bwhelm/aristotle-split33-2021/locations.md

# Locations of Parts

| Component |  $X$ pos |  $Y$ pos | Rot |
|:---|---:|---:|---:|
| D2A1 |  $79.63$ | $116.87$ |  $90$ |
| J1 |  $72.96$ | $123.01$ | $270$ |
| J3 |  $69.27$ | $114.91$ | $0$ |
| Mount Hole #1 2.2mm |  $61.18$ | $115.83$ | $0$ |
| Mount Hole #2 2.2mm |  $76.42$ | $115.83$ | $0$ |
| Mount Hole #3 2.2mm |  $79.69$ |  $80.34$ | $0$ |
| SW1 | $102.38$ | $142.15$ |  $24$ |
| SW2 |  $60.05$ | $137.42$ | $0$ |
| U1 |  $68.80$ |  $96.70$ | $270$ |
| Top of board | |  $78.62$ | |
| Left of board |  $58.51$ | | |
| Bottom of J3 | | $119.00$ | |
| Right of U1 |  $78.00$ | | |
| Right of Mount |  $81.41$ | | |

# Dimensions of MCU Cover:

$(119 - 78.62) \times (78 - 58.51)$
= $40.38 \times 19.49$ ... plus I need the extra loop for the third mounting hole

... Of course, I need to identify the locations of the mounting holes very carefully.... Here they are relative to the bottom left corner of the cover:

MH #1: $(61.18 - 58.51) \times (119 - 115.83) =  2.67 \times  3.17$

MH #2: $(76.42 - 58.51) \times (119 - 115.83) = 17.91 \times  3.17$

MH #3: $(79.69 - 58.51) \times (119 -  80.34) = 21.18 \times 38.66$

# Things to Check

What spacing between keys do I want? Should I make it all for choc keycaps, or should I allow the use of DSA keycaps? ... How much of a compromise will it be to allow the use of choc2 switches?
