bwhelm/aristotle-split33-2021/aristotle_split_2021_33_mcu_cover.stl

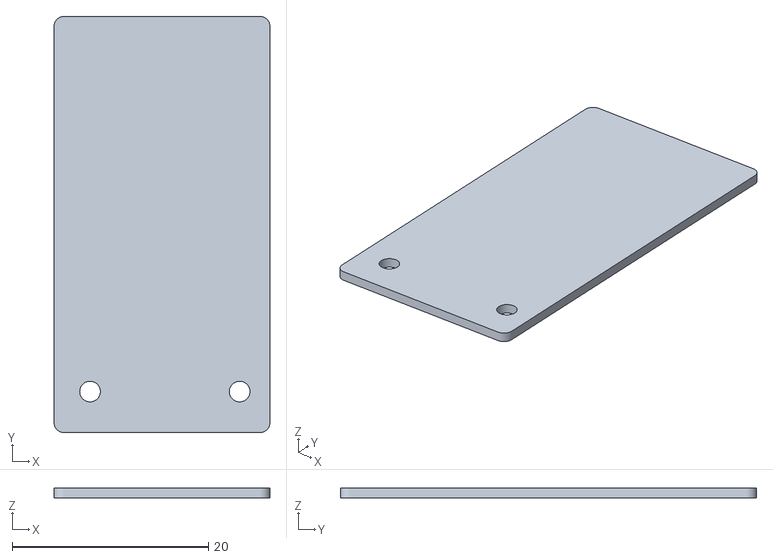
[picture p1: CAD file, 2021-08-19]
aristotle_split_2021_33_mcu_cover.stl
22.0 x 42.4 x 1.00
