bwhelm/aristotle-split33-2021/case/aristotle_split_33_keyboard-2021-case-right.stl

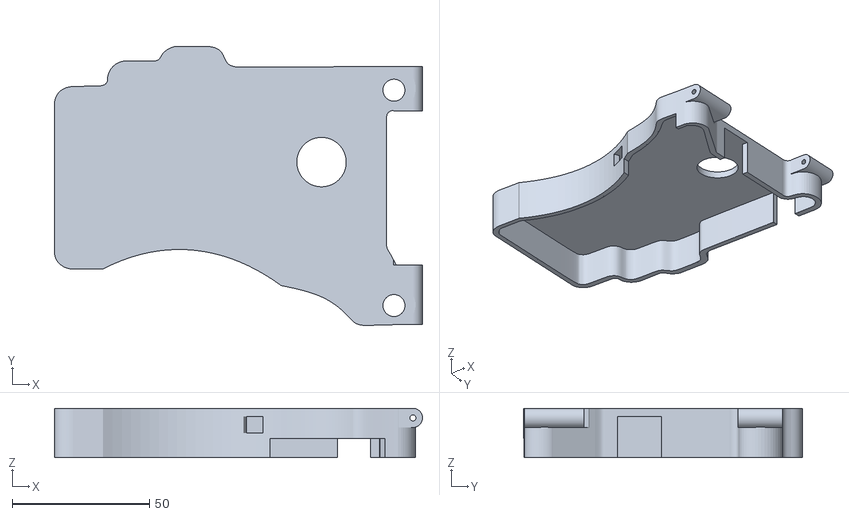
[picture p2: CAD file, 2021-08-19]
case/aristotle_split_33_keyboard-2021-case-right.stl
134.1 x 101.6 x 18.0
