bwhelm/aristotle-split33-2021/case/aristotle_split_33_keyboard-2021-case-open.stl

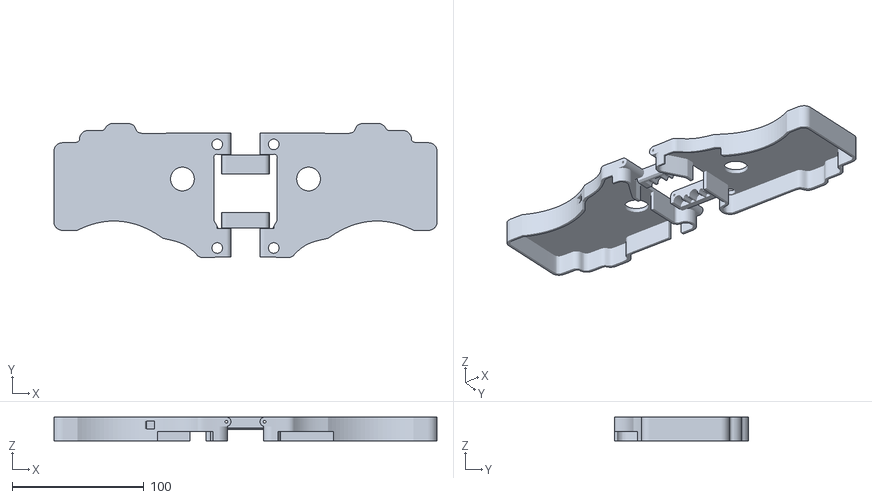
[picture p3: CAD file, 2021-08-19]
case/aristotle_split_33_keyboard-2021-case-open.stl
290.2 x 101.6 x 18.0
