bwhelm/aristotle-split33-2021/case/aristotle_split_33_keyboard-2021-case-hinge.stl

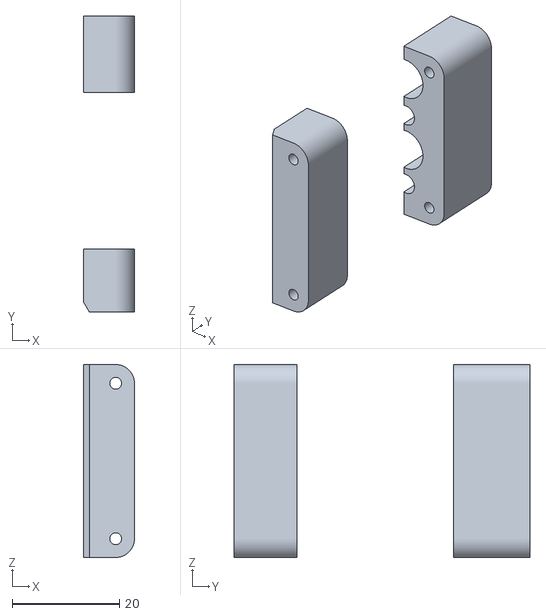
[picture p4: CAD file, 2021-08-19]
case/aristotle_split_33_keyboard-2021-case-hinge.stl
9.50 x 55.2 x 36.0
