bwhelm/aristotle-split33-2021/case/aristotle_split_33_keyboard-2021-case-closed.stl

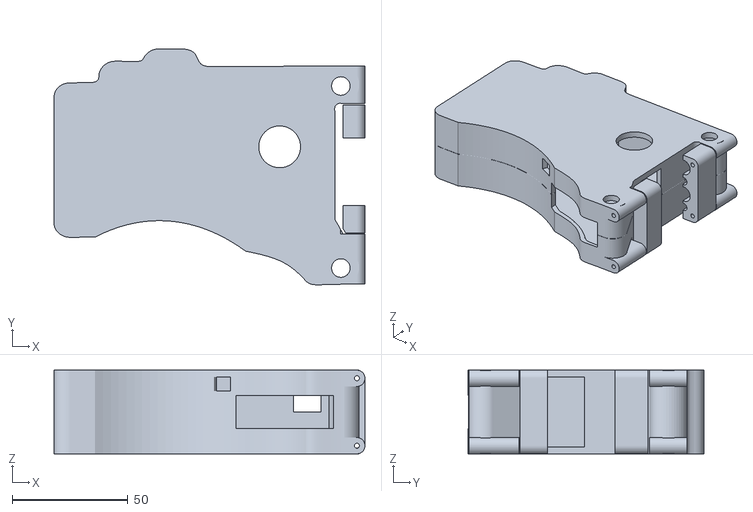
[picture p5: CAD file, 2021-08-19]
case/aristotle_split_33_keyboard-2021-case-closed.stl
134.1 x 101.6 x 36.1
