bwhelm/aristotle-split33-2021/case/aristotle_split_33_keyboard-2021-case-left.stl

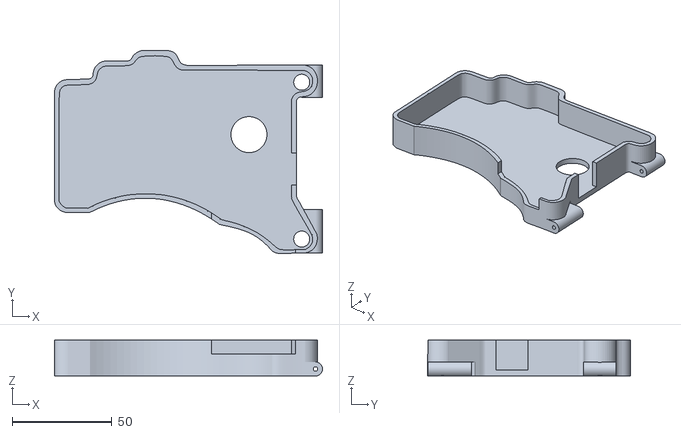
[picture p6: CAD file, 2021-08-19]
case/aristotle_split_33_keyboard-2021-case-left.stl
134.1 x 101.6 x 18.0
