bwhelm/aristotle-split33-2021/(list of files, cad)

Other CAD files:
aristotle_split_2021_33_mcu_cover.scad
aristotle_split_2021_33_mcu_cover.dxf
