bwhelm/aristotle-split33-2021/aristotle_split_33_keyboard-2021.kicad_pcb

## KiCad design aristotle_split_33_keyboard-2021.kicad_pcb (2021-08-19)

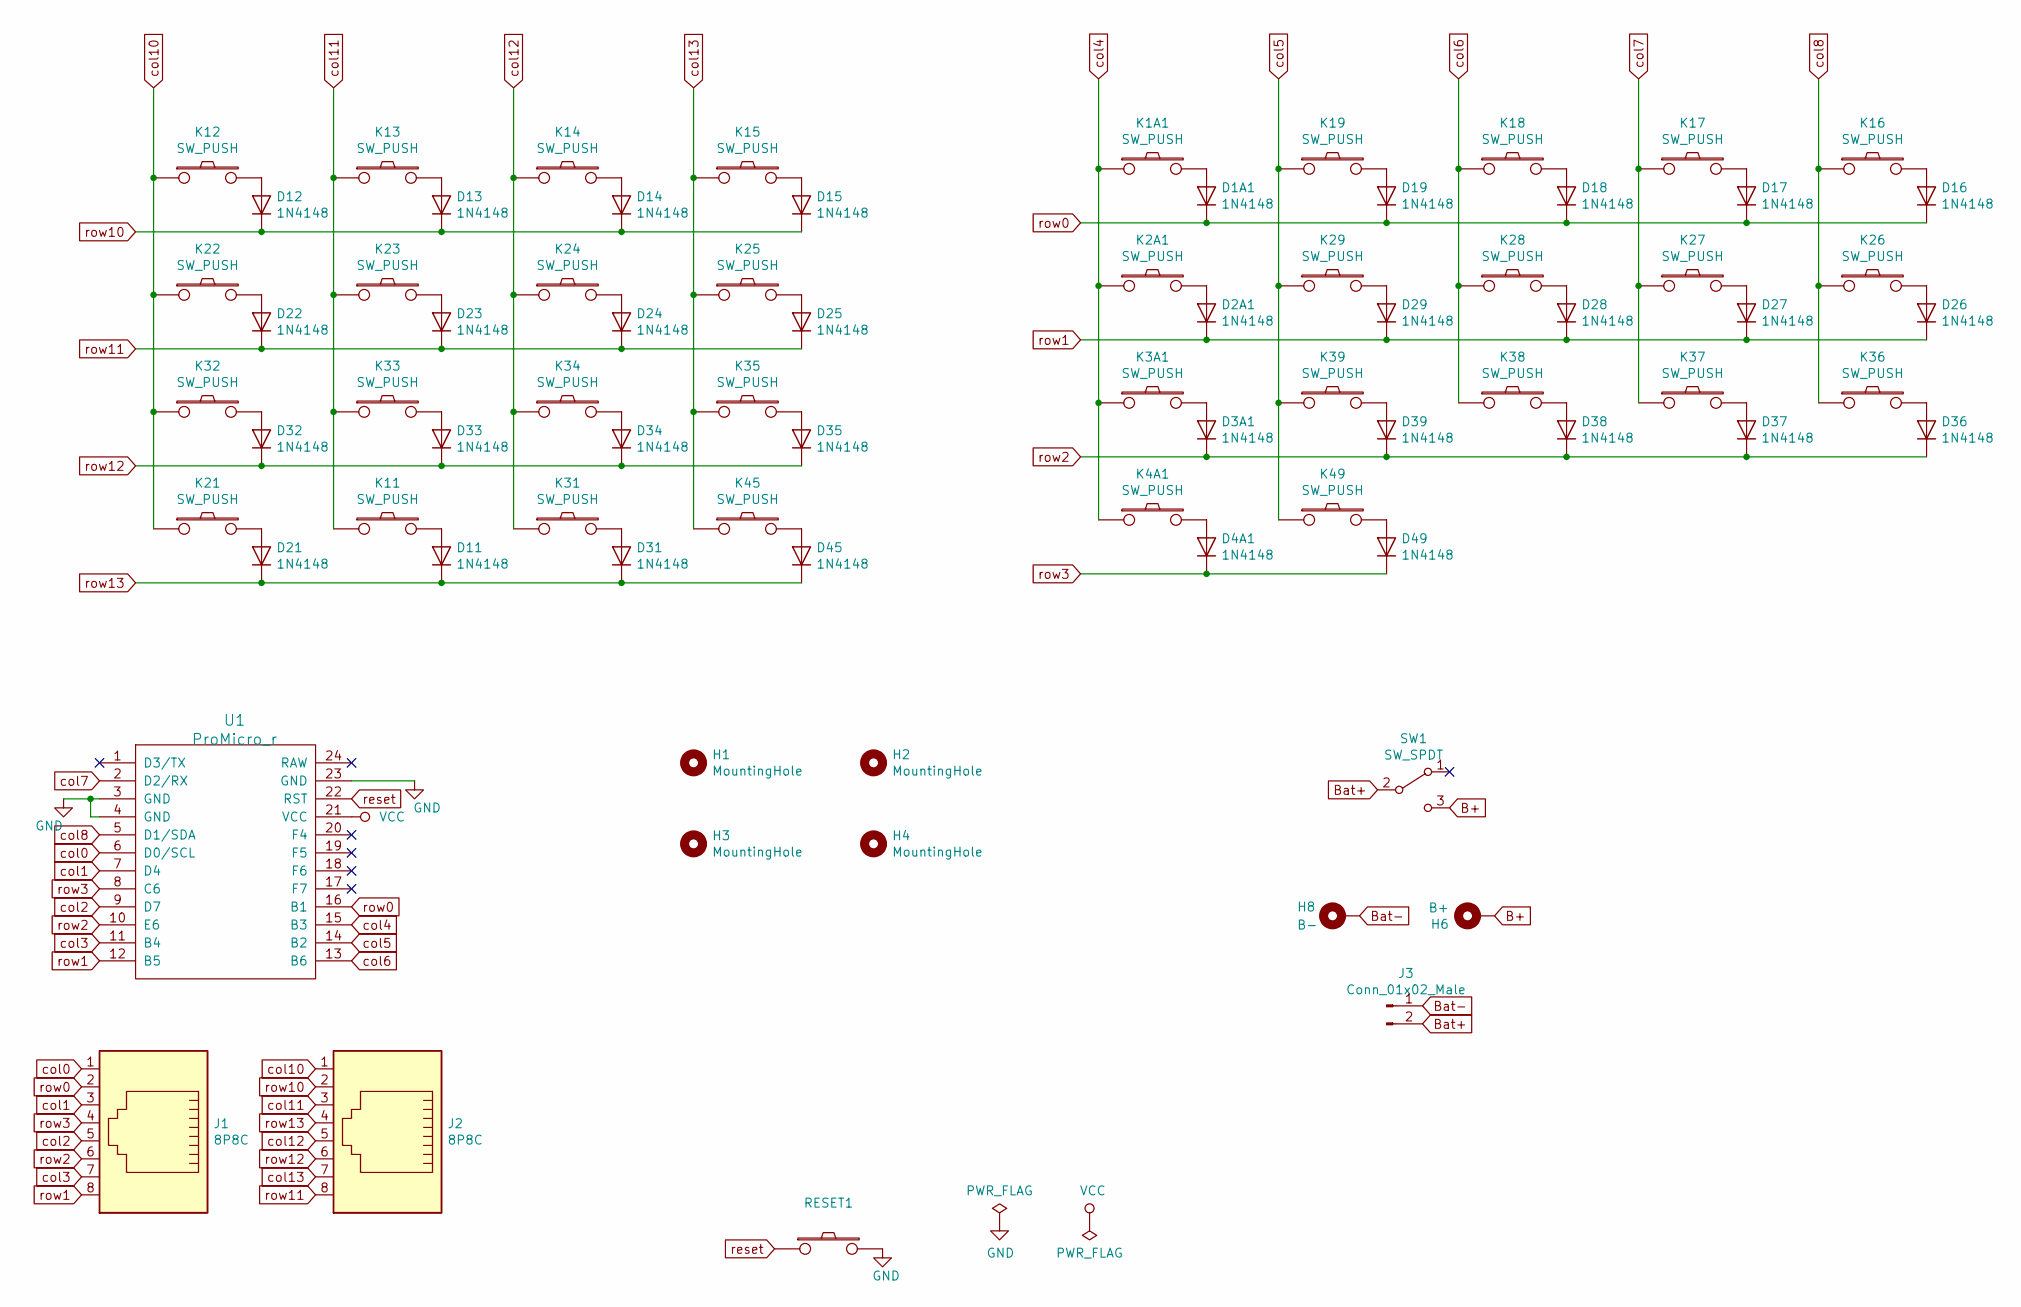
[picture p7: schematic aristotle_split_33_keyboard-2021.sch, Aristotle 33 Split]

Parts:
D1A1, D2A1, D3A1, D4A1, D11, D12, D13, D14, D15, D16, D17, D18, D19, D21, D22, D23, D24, D25, D26, D27, D28, D29, D31, D32, D33, D34, D35, D36, D37, D38, D39, D45, D49: 1N4148; D_T-1_P5.08mm_Horizontal-NO_B.SILK
H1, H2, H3, H4: MountingHole; MountingHole_6mm
H6: B+; PinHeader_1x01_P2.54mm_Vertical
H8: B-; PinHeader_1x01_P2.54mm_Vertical
J1, J2: 8P8C; RJ45_Amphenol_54602-x08_Horizontal
J3: Conn_01x02_Male; PinHeader_1x02_P2.54mm_Vertical_SMD_Pin1Left
K1A1, K2A1, K3A1, K4A1, K11, K12, K13, K14, K15, K16, K17, K18, K19, K21, K22, K23, K24, K25, K26, K27, K28, K29, K31, K32, K33, K34, K35, K36, K37, K38, K39, K45, K49: SW_PUSH; Kailh-Choc_1350-Keyswitch-NONREVERSIBLE
RESET1: SW_PUSH_6mm
SW1: SW_SPDT; SW_CuK_OS102011MA1QN1_SPDT_Angled
U1: ProMicro_r; ProMicro

Connections:
B+: H6.1, SW1.3 (C)
Bat+: J3.2, SW1.2 (B)
Bat-: H8.1, J3.1
GND: RESET1.2, U1.3 (GND), U1.4 (GND), U1.23 (GND)
unnamed: D1A1.2 (A), K1A1.2
unnamed: D2A1.2 (A), K2A1.2
unnamed: D3A1.2 (A), K3A1.2
unnamed: D4A1.2 (A), K4A1.2
unnamed: D11.2 (A), K11.2
unnamed: D12.2 (A), K12.2
unnamed: D13.2 (A), K13.2
unnamed: D14.2 (A), K14.2
unnamed: D15.2 (A), K15.2
unnamed: D16.2 (A), K16.2
unnamed: D17.2 (A), K17.2
unnamed: D18.2 (A), K18.2
unnamed: D19.2 (A), K19.2
unnamed: D21.2 (A), K21.2
unnamed: D22.2 (A), K22.2
unnamed: D23.2 (A), K23.2
unnamed: D24.2 (A), K24.2
unnamed: D25.2 (A), K25.2
unnamed: D26.2 (A), K26.2
unnamed: D27.2 (A), K27.2
unnamed: D28.2 (A), K28.2
unnamed: D29.2 (A), K29.2
unnamed: D31.2 (A), K31.2
unnamed: D32.2 (A), K32.2
unnamed: D33.2 (A), K33.2
unnamed: D34.2 (A), K34.2
unnamed: D35.2 (A), K35.2
unnamed: D36.2 (A), K36.2
unnamed: D37.2 (A), K37.2
unnamed: D38.2 (A), K38.2
unnamed: D39.2 (A), K39.2
unnamed: D45.2 (A), K45.2
unnamed: D49.2 (A), K49.2
col0: J1.1, U1.6 (D0/SCL)
col1: J1.3, U1.7 (D4)
col2: J1.5, U1.9 (D7)
col3: J1.7, U1.11 (B4)
col4: K1A1.1, K2A1.1, K3A1.1, K4A1.1, U1.15 (B3)
col5: K19.1, K29.1, K39.1, K49.1, U1.14 (B2)
col6: K18.1, K28.1, K38.1, U1.13 (B6)
col7: K17.1, K27.1, K37.1, U1.2 (D2/RX)
col8: K16.1, K26.1, K36.1, U1.5 (D1/SDA)
col10: J2.1, K12.1, K21.1, K22.1, K32.1
col11: J2.3, K11.1, K13.1, K23.1, K33.1
col12: J2.5, K14.1, K24.1, K31.1, K34.1
col13: J2.7, K15.1, K25.1, K35.1, K45.1
reset: RESET1.1, U1.22 (RST)
row0: D1A1.1 (K), D16.1 (K), D17.1 (K), D18.1 (K), D19.1 (K), J1.2, U1.16 (B1)
row1: D2A1.1 (K), D26.1 (K), D27.1 (K), D28.1 (K), D29.1 (K), J1.8, U1.12 (B5)
row2: D3A1.1 (K), D36.1 (K), D37.1 (K), D38.1 (K), D39.1 (K), J1.6, U1.10 (E6)
row3: D4A1.1 (K), D49.1 (K), J1.4, U1.8 (C6)
row10: D12.1 (K), D13.1 (K), D14.1 (K), D15.1 (K), J2.2
row11: D22.1 (K), D23.1 (K), D24.1 (K), D25.1 (K), J2.8
row12: D32.1 (K), D33.1 (K), D34.1 (K), D35.1 (K), J2.6
row13: D11.1 (K), D21.1 (K), D31.1 (K), D45.1 (K), J2.4

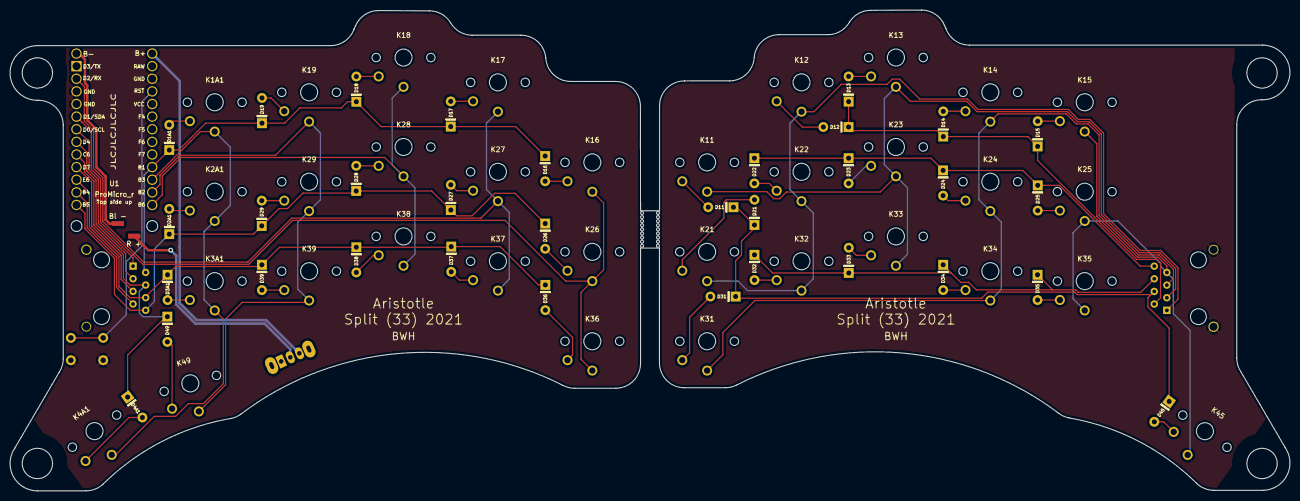
[picture p8: board aristotle_split_33_keyboard-2021.kicad_pcb from above]

Board: 2 copper layers, 257.6 x 96.8 mm, 82 parts (0 on the bottom side), 59 nets.

Other parts of the board:
1, 2: MountingHole_2.2mm_M2
breakaway: Stamp_Holes_7.5mm
breakaway#2: Stamp_Holes_7.5mm
